P2014/HubChuk/Hardware/Lilypad-USB.jpg

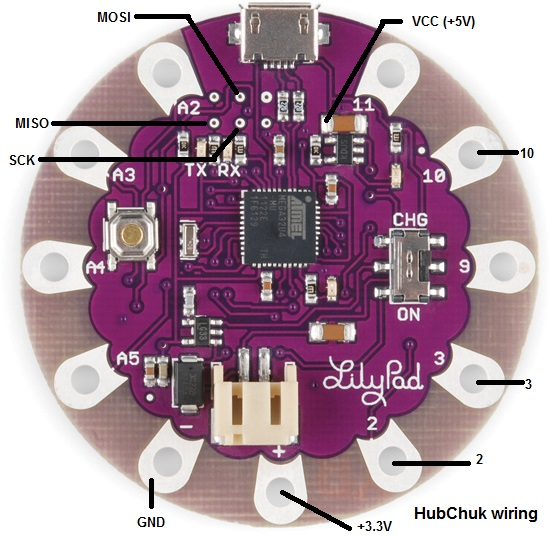
Hardware/Lilypad-USB.jpg
