P2014/HubChuk/Hardware/XL7105.jpg

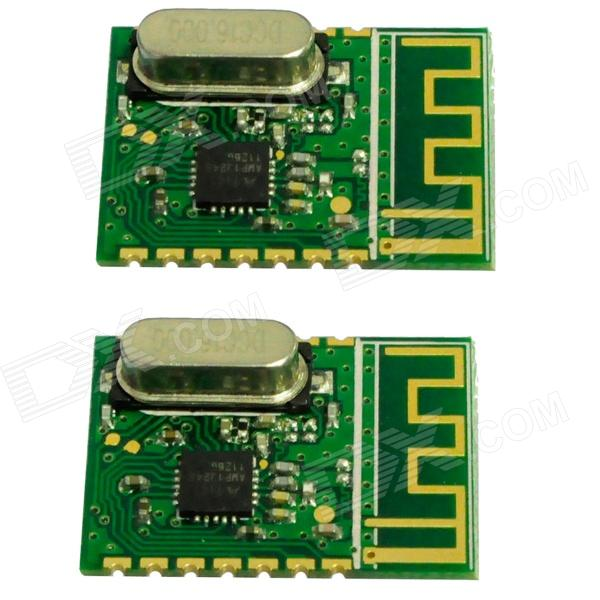
Hardware/XL7105.jpg
