P2014/HubChuk/Hardware/HubChuk_schematic.png

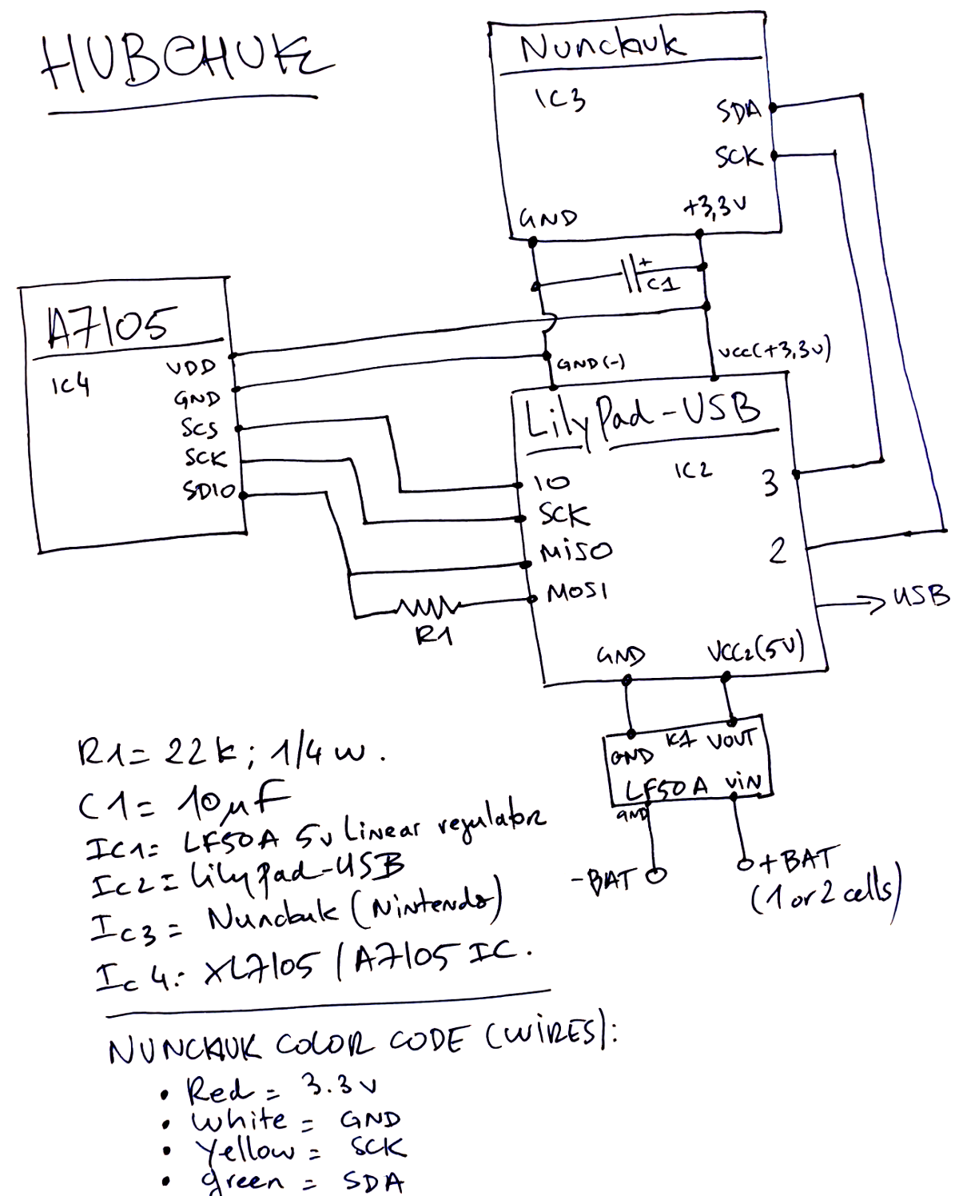
Hardware/HubChuk_schematic.png
