P2014/HubChuk/(commit log)

2014-01-15 BOM added
2014-01-15 Added schematics (Lilypad-USB and HubChuk)
2014-01-15 Updated BOM and Readme
